mehmetfurkandogan/Microprocessor-Controlled-Prosthetic-Knee/Controller GUI/c-leg.png

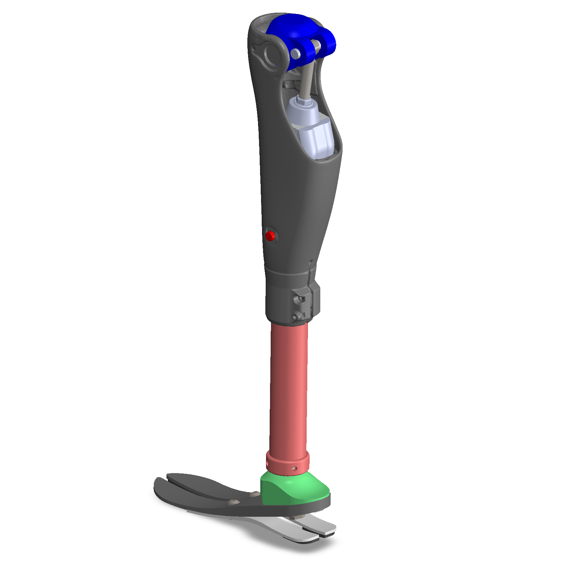
Controller GUI/c-leg.png
