mehmetfurkandogan/Microprocessor-Controlled-Prosthetic-Knee/Simulink_Simulation/C-Leg STEP/Valf/assembly_v2.SLDASM

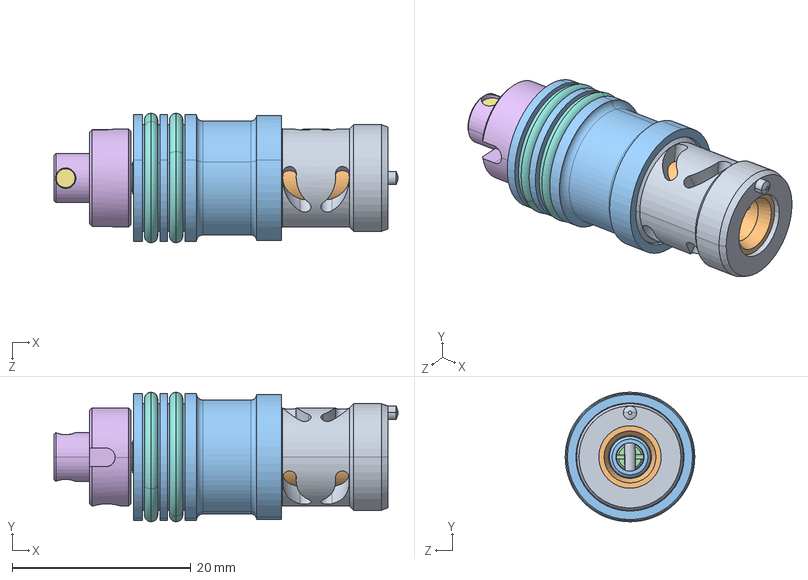
[picture p3: CAD file, 2023-01-23]
Simulink_Simulation/C-Leg STEP/Valf/assembly_v2.SLDASM
38.5 x 14.5 x 14.5 mm
Part9_by_can.step
ic_parca_step.step
Part3_step.step
motor_shaft_step.step
buyuk_pul_step.step
Part4_step.step
Part2_step.step
jonta_step.step
pim_step.step
Part6_step.step
Part7_step.step
kucuk_pul_step.step
Part10_step.step
Part11_step.step
mıknatıs_step.step
o_ring_step.step x 2
