mehmetfurkandogan/Microprocessor-Controlled-Prosthetic-Knee/Simulink_Simulation/karbon ayak/karbon ayak step/assembly step.STEP

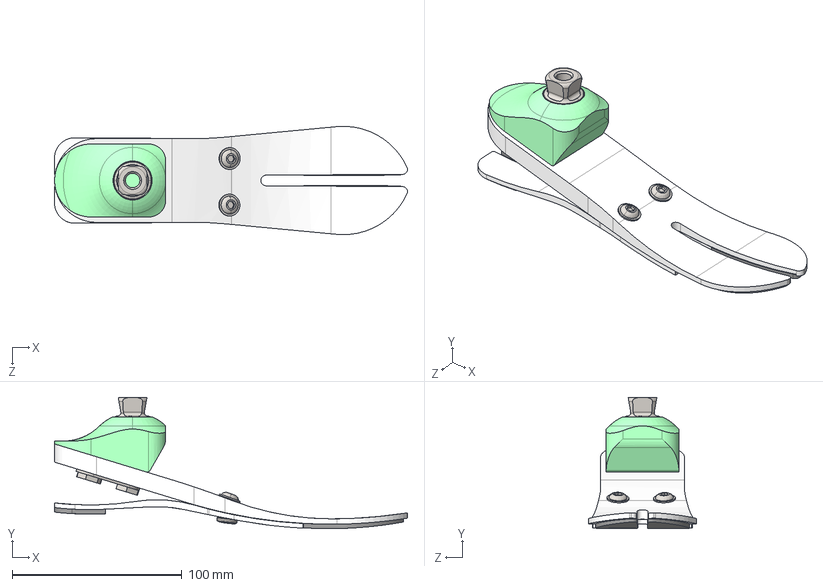
[picture p4: CAD file, 2023-01-23]
Simulink_Simulation/karbon ayak/karbon ayak step/assembly step.STEP
208.0 x 77.5 x 63.8 mm
TI.2K.PT10
DT.2P. KTB2
DT.2P.KTBN
YH.PU.K207
TI.VI.A816 x 2
HP.VI.I612_K6SF1006012_BUFAB x 2
TI.K2.0004
KA.KL.027U
KA.KL.027A
TI.K7.0003 x 2
TI.VI.A820
