mehmetfurkandogan/Microprocessor-Controlled-Prosthetic-Knee/Simulink_Simulation/C-Leg STEP/Valf/montaj_ic_aksam_v3.SLDASM

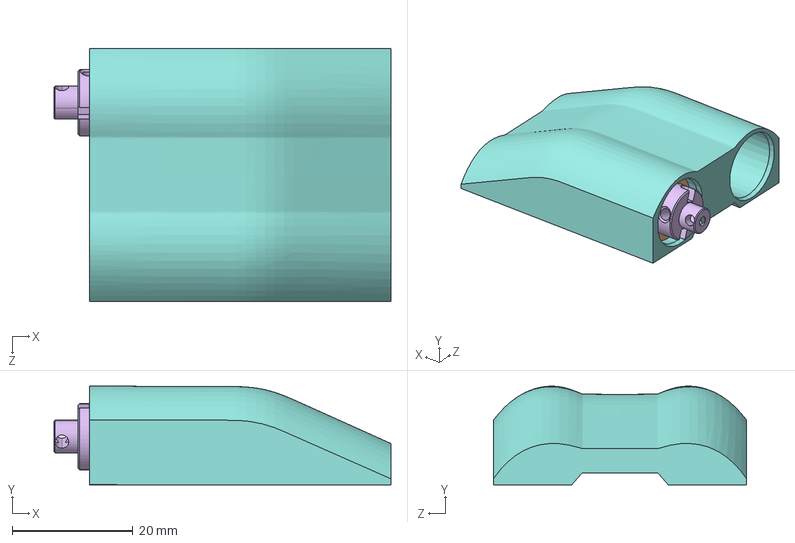
[picture p6: CAD file, 2023-01-23]
Simulink_Simulation/C-Leg STEP/Valf/montaj_ic_aksam_v3.SLDASM
55.9 x 16.4 x 42.0 mm
Part9_by_can.step
motor_shaft_step.step
buyuk_pul_step.step
Part3_step.step
pim_step.step
ic_parca_step.step
Part4_step.step
Part6_step.step
Part7_step.step
Part2_step.step
jonta_step.step
kucuk_pul_step.step
Part11_step.step
o_ring_step x 2
