mehmetfurkandogan/Microprocessor-Controlled-Prosthetic-Knee/Simulink_Simulation/C-Leg STEP/Valf/Assem1.SLDASM

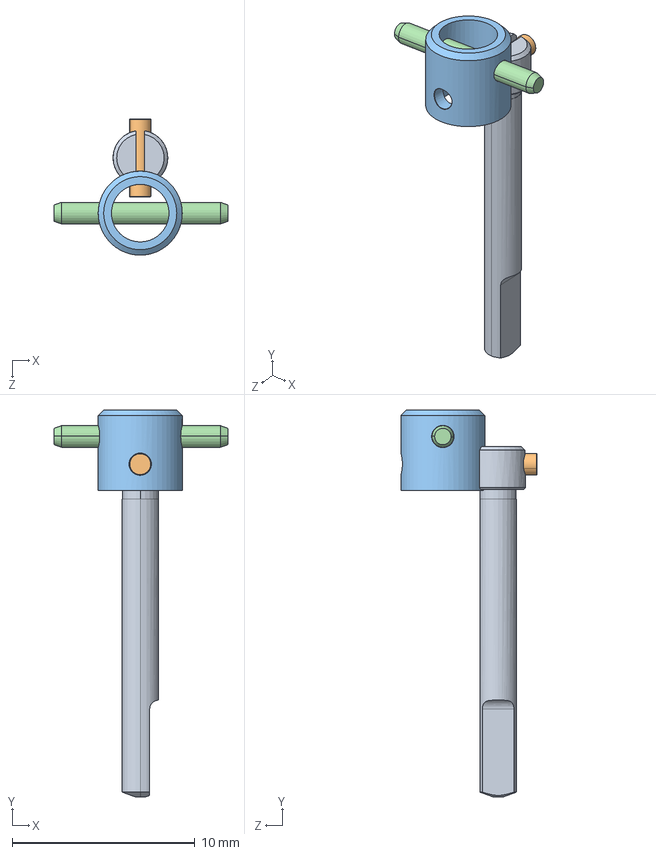
[picture p7: CAD file, 2023-01-23]
Simulink_Simulation/C-Leg STEP/Valf/Assem1.SLDASM
9.50 x 21.2 x 7.46 mm
motor_shaft_step.step
Part5_step.step
Part3_step.step
pim_step.step
