mehmetfurkandogan/Microprocessor-Controlled-Prosthetic-Knee/Simulink_Simulation/C-Leg STEP/Valf/montaj.SLDASM

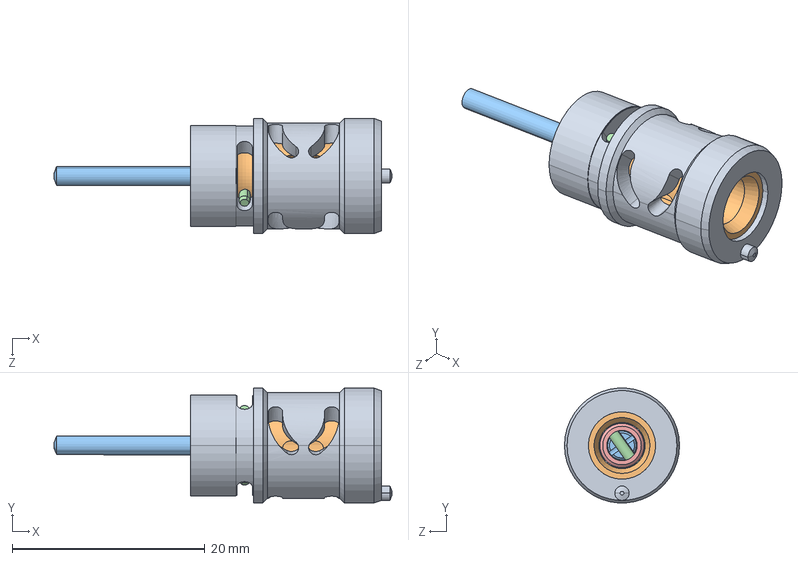
[picture p8: CAD file, 2023-01-23]
Simulink_Simulation/C-Leg STEP/Valf/montaj.SLDASM
35.1 x 11.9 x 11.9 mm
dis_parca_step.step
ic_parca_step.step
motor_shaft_step.step
pim_step.step
Part3_step.step
buyuk_pul_step.step
