mehmetfurkandogan/Microprocessor-Controlled-Prosthetic-Knee/Simulink_Simulation/C-Leg STEP/Valf/montaj_ic_aksam.SLDASM

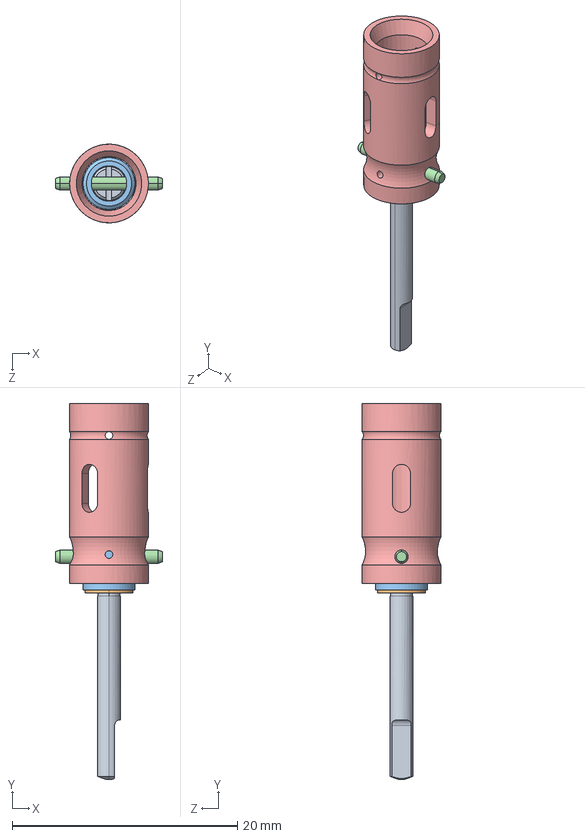
[picture p9: CAD file, 2023-01-23]
Simulink_Simulation/C-Leg STEP/Valf/montaj_ic_aksam.SLDASM
9.50 x 33.4 x 6.99 mm
motor_shaft_step.step
buyuk_pul_step.step
Part3_step.step
pim_step.step
ic_parca_step.step
