mehmetfurkandogan/Microprocessor-Controlled-Prosthetic-Knee/Simulink_Simulation/C-Leg STEP/Parçalar/valf_govdesi_v2.STEP

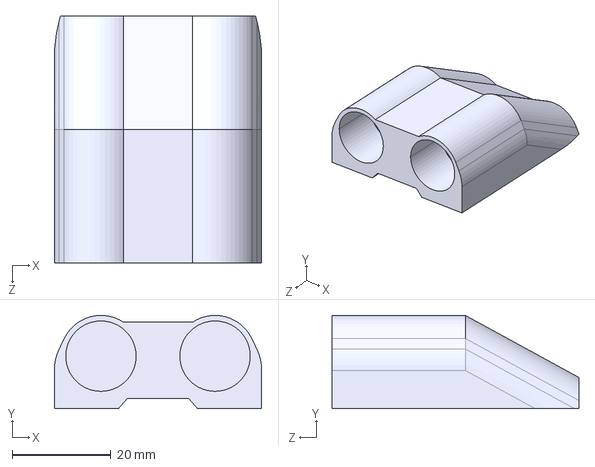
[picture p10: CAD file, 2023-01-23]
Simulink_Simulation/C-Leg STEP/Parçalar/valf_govdesi_v2.STEP
42.0 x 18.9 x 50.0 mm
