mehmetfurkandogan/Microprocessor-Controlled-Prosthetic-Knee/Simulink_Simulation/C-Leg STEP/Valf/kucuk_pul_step.STEP

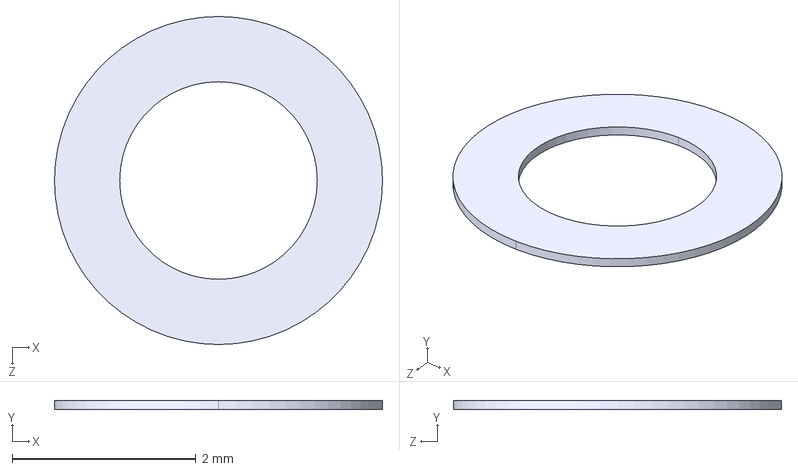
[picture p11: CAD file, 2023-01-23]
Simulink_Simulation/C-Leg STEP/Valf/kucuk_pul_step.STEP
3.57 x 0.1 x 3.57 mm
