mehmetfurkandogan/Microprocessor-Controlled-Prosthetic-Knee/Simulink_Simulation/karbon ayak/karbon ayak step/DT.2P.KTBN.STEP

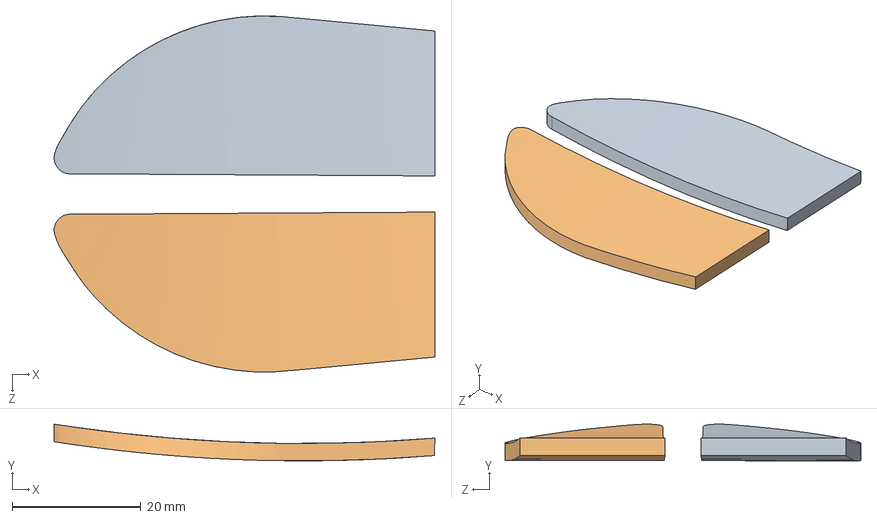
[picture p12: CAD file, 2023-01-23]
Simulink_Simulation/karbon ayak/karbon ayak step/DT.2P.KTBN.STEP
59.1 x 5.71 x 55.2 mm
