mehmetfurkandogan/Microprocessor-Controlled-Prosthetic-Knee/Simulink_Simulation/simulink/boru.STEP

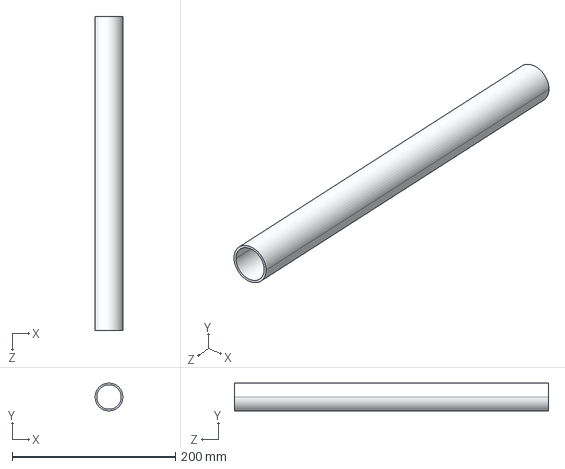
[picture p14: CAD file, 2023-01-23]
Simulink_Simulation/simulink/boru.STEP
34.0 x 34.0 x 385.0 mm
