mehmetfurkandogan/Microprocessor-Controlled-Prosthetic-Knee/Simulink_Simulation/C-Leg STEP/Parçalar/Cool-Step Govde_v2.step.SLDPRT

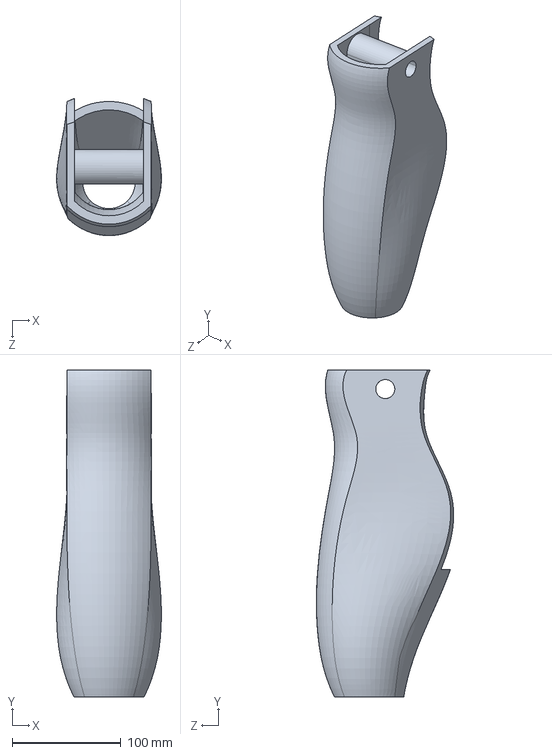
[picture p15: CAD file, 2023-01-23]
Simulink_Simulation/C-Leg STEP/Parçalar/Cool-Step Govde_v2.step.SLDPRT
96.1 x 300.0 x 126.0 mm
