mehmetfurkandogan/Microprocessor-Controlled-Prosthetic-Knee/Simulink_Simulation/C-Leg STEP/Valf/o_ring_step.STEP

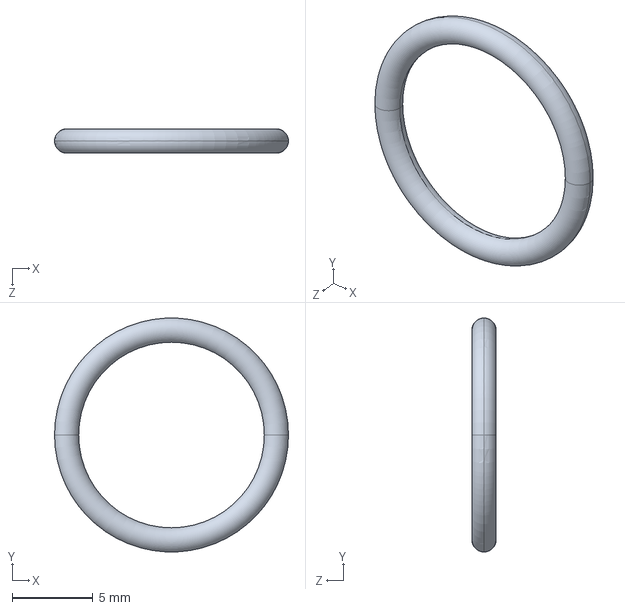
[picture p16: CAD file, 2023-01-23]
Simulink_Simulation/C-Leg STEP/Valf/o_ring_step.STEP
14.5 x 14.5 x 1.50 mm
