mehmetfurkandogan/Microprocessor-Controlled-Prosthetic-Knee/Simulink_Simulation/diz.STEP

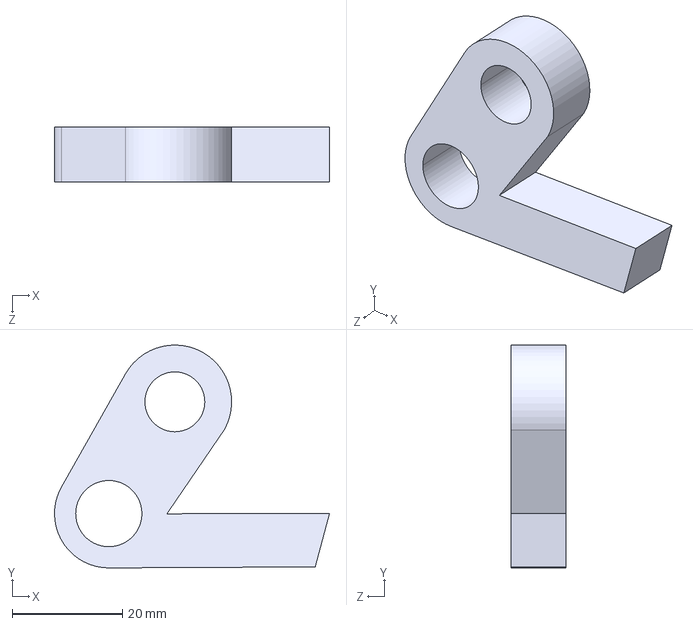
[picture p17: CAD file, 2023-01-23]
Simulink_Simulation/diz.STEP
49.8 x 40.4 x 10.0 mm
