mehmetfurkandogan/Microprocessor-Controlled-Prosthetic-Knee/Simulink_Simulation/karbon ayak/HP.VI.I612.SLDPRT

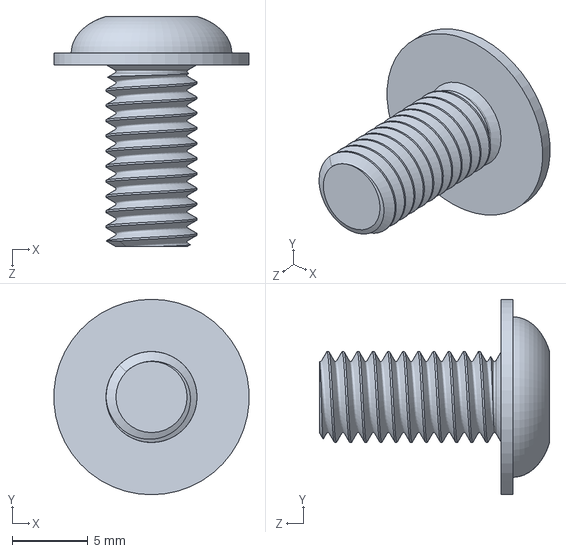
[picture p18: CAD file, 2023-01-23]
Simulink_Simulation/karbon ayak/HP.VI.I612.SLDPRT
12.9 x 12.9 x 15.2 mm
