mehmetfurkandogan/Microprocessor-Controlled-Prosthetic-Knee/Simulink_Simulation/karbon ayak/karbon ayak step/KA.KL.027U.STEP

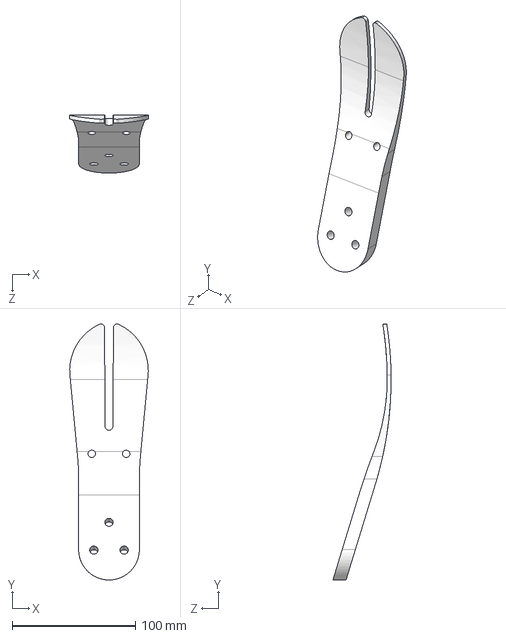
[picture p19: CAD file, 2023-01-23]
Simulink_Simulation/karbon ayak/karbon ayak step/KA.KL.027U.STEP
63.8 x 208.0 x 47.3 mm
