mehmetfurkandogan/Microprocessor-Controlled-Prosthetic-Knee/Simulink_Simulation/simulink/01-ADAPTÖR.STEP

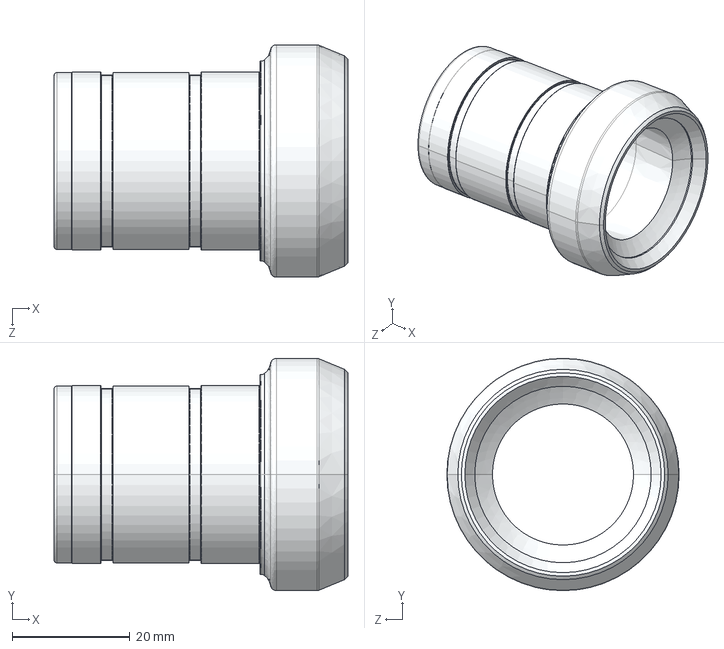
[picture p20: CAD file, 2023-01-23]
Simulink_Simulation/simulink/01-ADAPTÖR.STEP
50.0 x 39.5 x 39.5 mm
