mehmetfurkandogan/Microprocessor-Controlled-Prosthetic-Knee/Simulink_Simulation/C-Leg STEP/Parçalar/diz.STEP

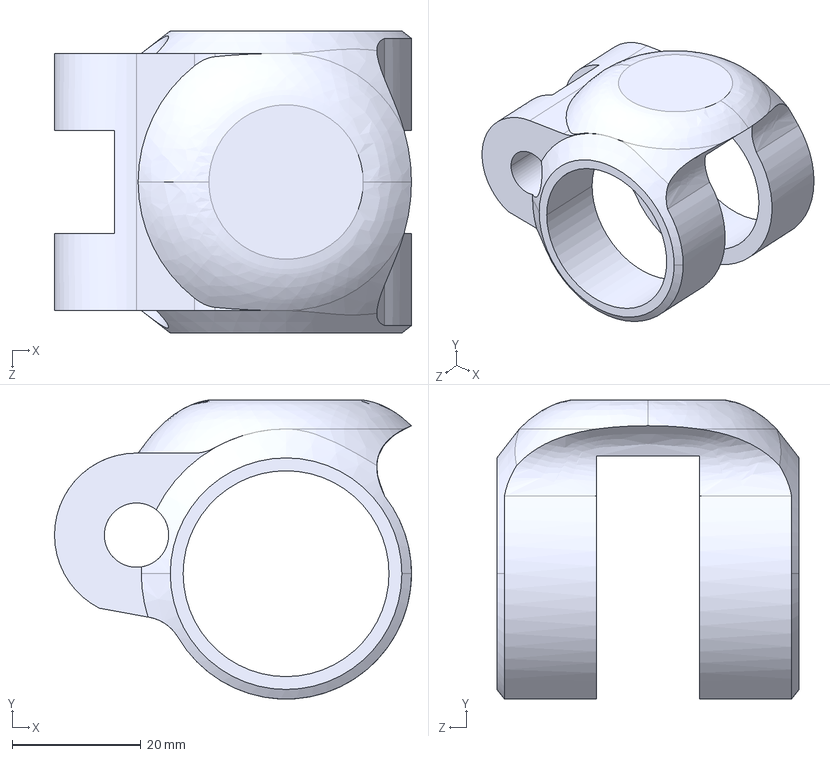
[picture p21: CAD file, 2023-01-23]
Simulink_Simulation/C-Leg STEP/Parçalar/diz.STEP
55.5 x 46.5 x 47.0 mm
