mehmetfurkandogan/Microprocessor-Controlled-Prosthetic-Knee/Simulink_Simulation/karbon ayak/karbon ayak step/KA.KL.027A.STEP

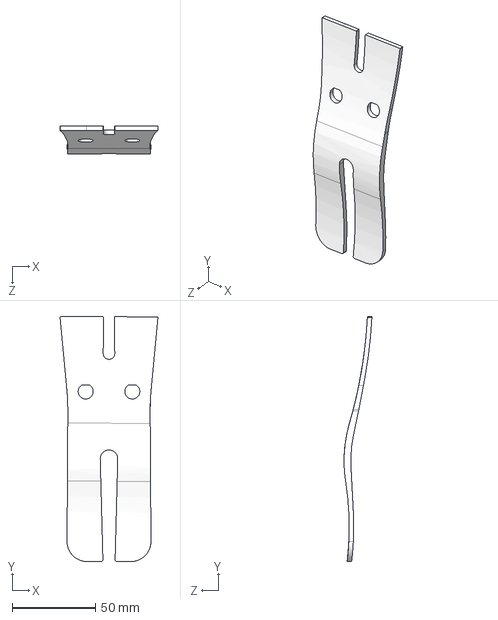
[picture p22: CAD file, 2023-01-23]
Simulink_Simulation/karbon ayak/karbon ayak step/KA.KL.027A.STEP
58.7 x 147.0 x 16.7 mm
