mehmetfurkandogan/Microprocessor-Controlled-Prosthetic-Knee/Simulink_Simulation/simulink/strain_gage_parcasi_kare.STEP

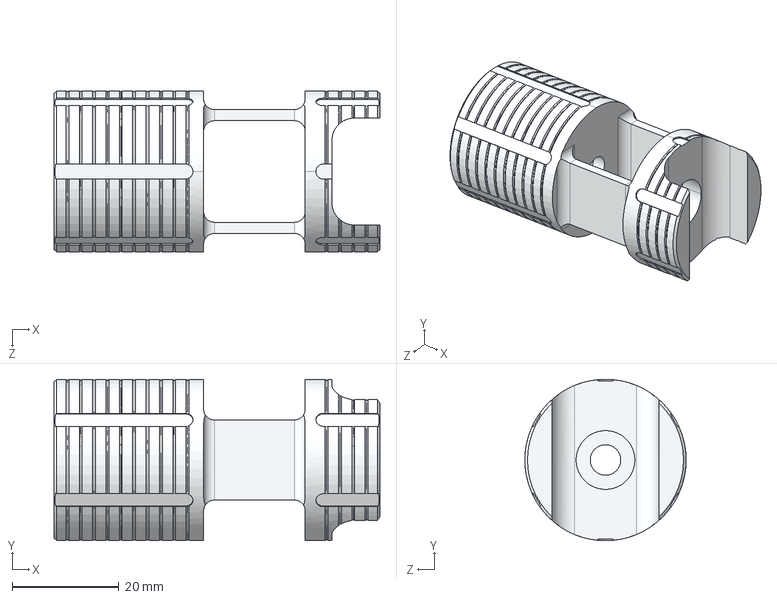
[picture p23: CAD file, 2023-01-23]
Simulink_Simulation/simulink/strain_gage_parcasi_kare.STEP
61.0 x 30.2 x 30.2 mm
