mehmetfurkandogan/Microprocessor-Controlled-Prosthetic-Knee/Simulink_Simulation/C-Leg STEP/Parçalar/hidrolikSilindir.STEP

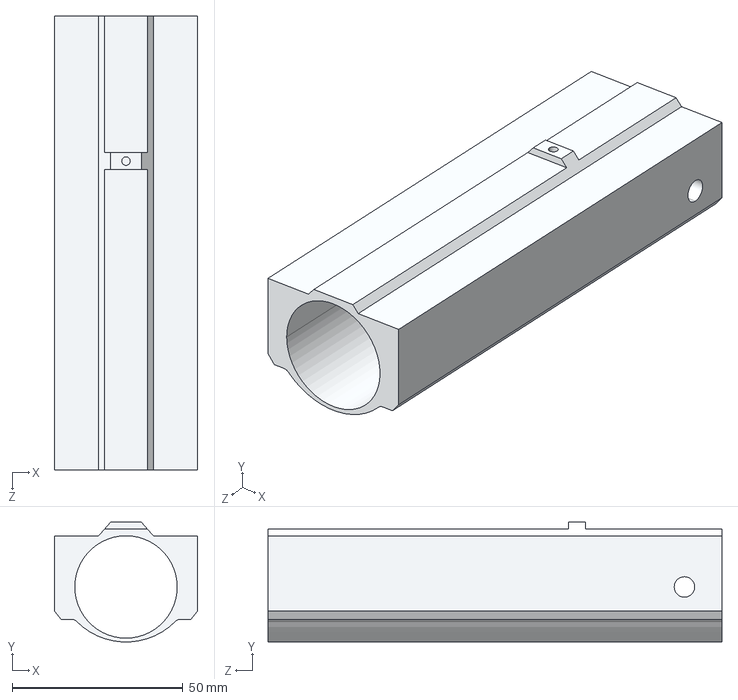
[picture p24: CAD file, 2023-01-23]
Simulink_Simulation/C-Leg STEP/Parçalar/hidrolikSilindir.STEP
42.0 x 35.1 x 133.0 mm
