mehmetfurkandogan/Microprocessor-Controlled-Prosthetic-Knee/Simulink_Simulation/C-Leg STEP/Valf/Part9_by_can.STEP

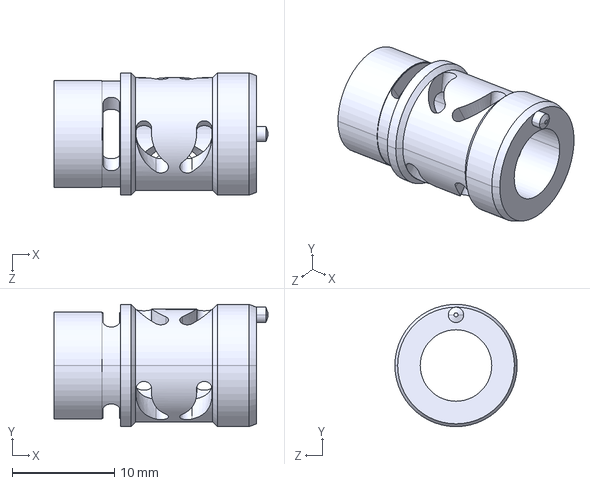
[picture p25: CAD file, 2023-01-23]
Simulink_Simulation/C-Leg STEP/Valf/Part9_by_can.STEP
20.9 x 12.0 x 12.0 mm
