mehmetfurkandogan/Microprocessor-Controlled-Prosthetic-Knee/Simulink_Simulation/simulink/boru_v2SLDPRT.SLDPRT

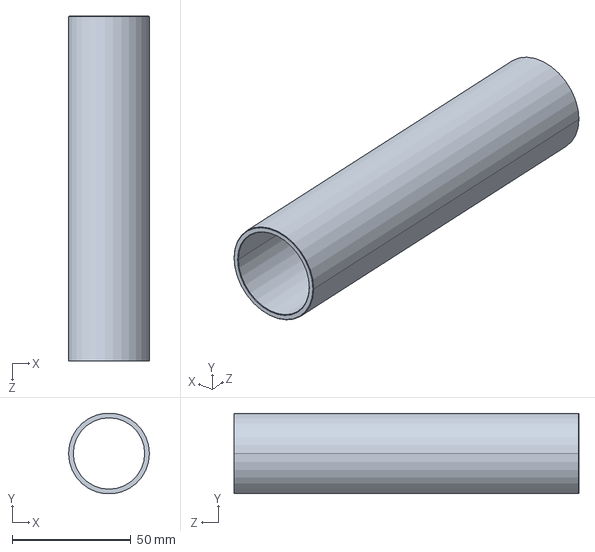
[picture p26: CAD file, 2023-01-23]
Simulink_Simulation/simulink/boru_v2SLDPRT.SLDPRT
34.0 x 33.8 x 145.0 mm
