mehmetfurkandogan/Microprocessor-Controlled-Prosthetic-Knee/Simulink_Simulation/C-Leg STEP/Parçalar/valf_govdesi_v3.SLDPRT

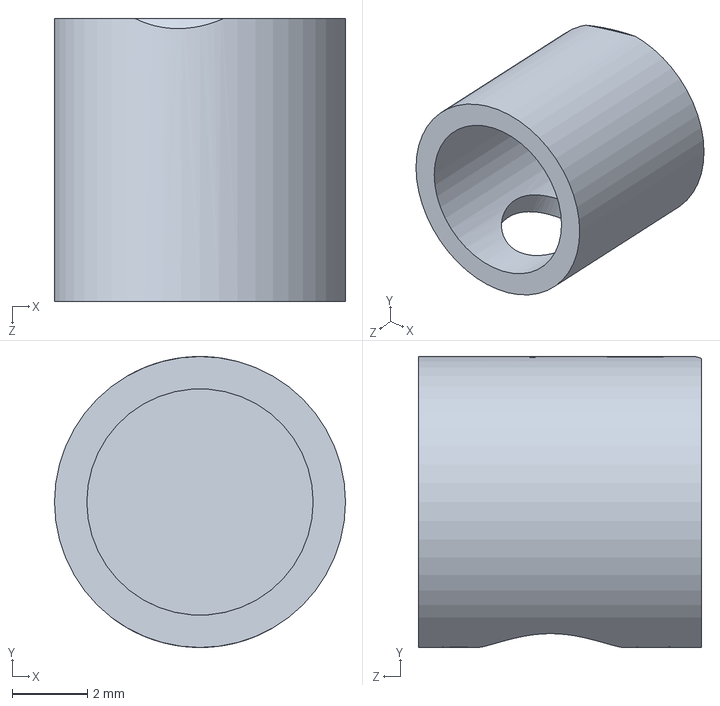
[picture p27: CAD file, 2023-01-23]
Simulink_Simulation/C-Leg STEP/Parçalar/valf_govdesi_v3.SLDPRT
7.72 x 7.72 x 7.50 mm
