mehmetfurkandogan/Microprocessor-Controlled-Prosthetic-Knee/Simulink_Simulation/C-Leg STEP/Valf/Part4_step.STEP

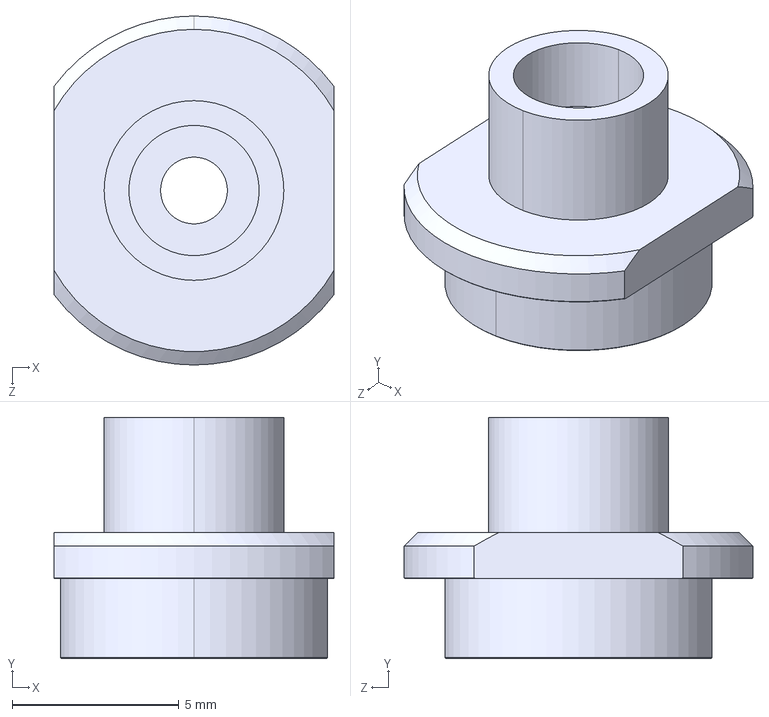
[picture p28: CAD file, 2023-01-23]
Simulink_Simulation/C-Leg STEP/Valf/Part4_step.STEP
8.38 x 7.22 x 10.5 mm
