mehmetfurkandogan/Microprocessor-Controlled-Prosthetic-Knee/Simulink_Simulation/karbon ayak/YH.PU.K207.SLDPRT

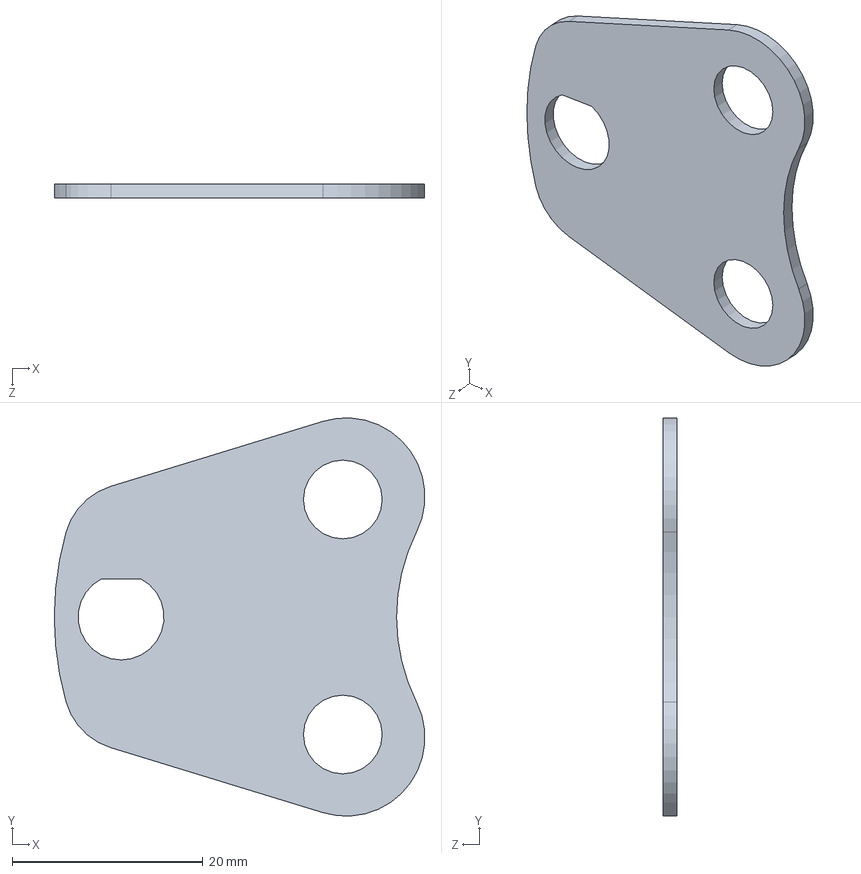
[picture p29: CAD file, 2023-01-23]
Simulink_Simulation/karbon ayak/YH.PU.K207.SLDPRT
38.8 x 41.7 x 1.50 mm
