mehmetfurkandogan/Microprocessor-Controlled-Prosthetic-Knee/Simulink_Simulation/karbon ayak/karbon ayak step/TI.K2.0004.STEP

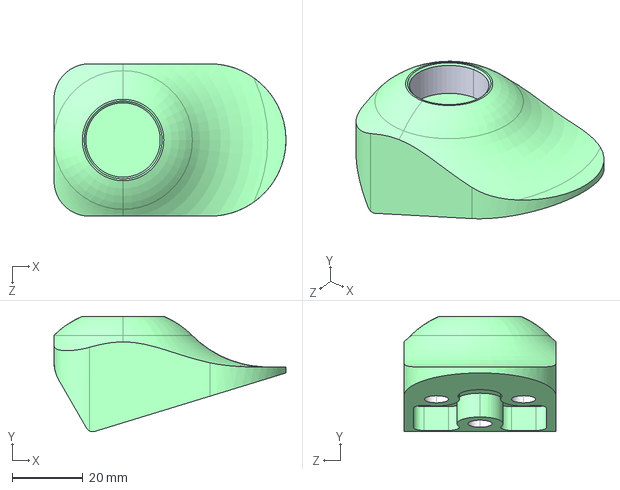
[picture p30: CAD file, 2023-01-23]
Simulink_Simulation/karbon ayak/karbon ayak step/TI.K2.0004.STEP
65.5 x 32.6 x 43.0 mm
