mehmetfurkandogan/Microprocessor-Controlled-Prosthetic-Knee/Simulink_Simulation/karbon ayak/TI.VI.A816.SLDPRT

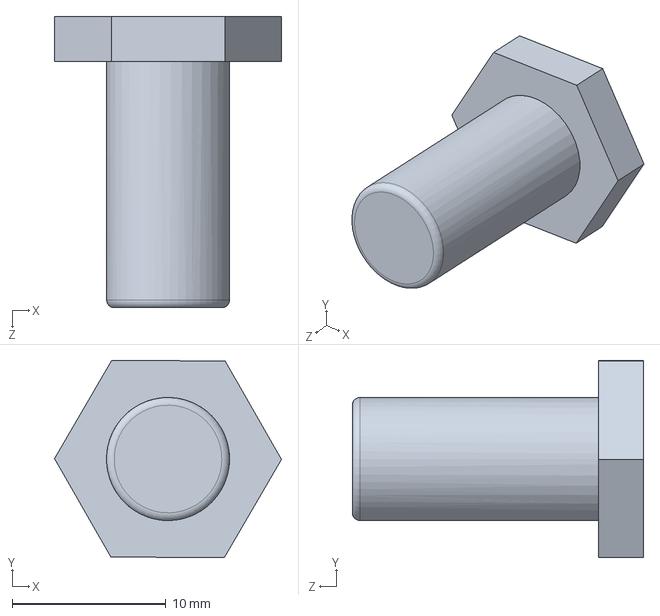
[picture p31: CAD file, 2023-01-23]
Simulink_Simulation/karbon ayak/TI.VI.A816.SLDPRT
14.8 x 12.8 x 19.0 mm
