mehmetfurkandogan/Microprocessor-Controlled-Prosthetic-Knee/Simulink_Simulation/C-Leg STEP/Valf/pim_step.STEP

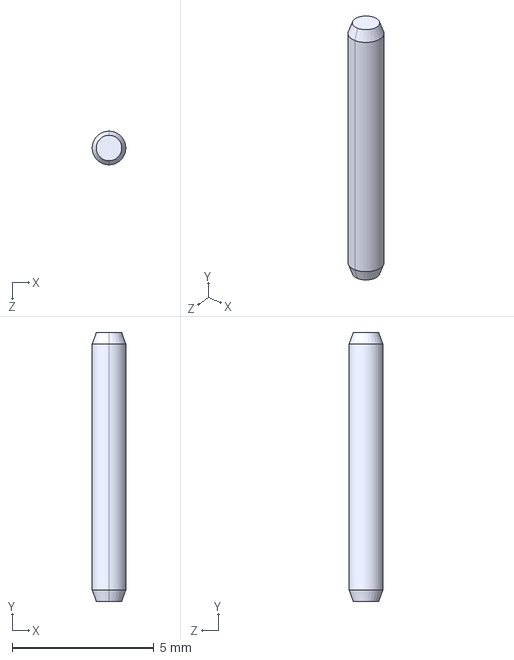
[picture p32: CAD file, 2023-01-23]
Simulink_Simulation/C-Leg STEP/Valf/pim_step.STEP
1.19 x 9.50 x 1.19 mm
