mehmetfurkandogan/Microprocessor-Controlled-Prosthetic-Knee/Simulink_Simulation/karbon ayak/karbon ayak step/DT.2P. KTB2.STEP

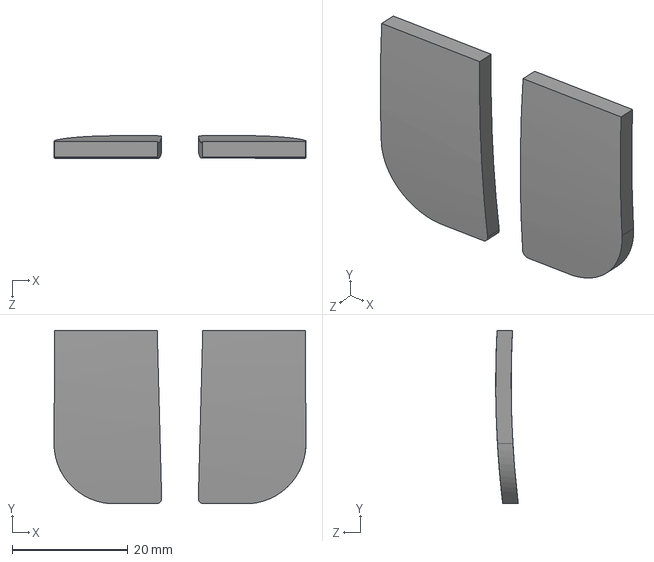
[picture p33: CAD file, 2023-01-23]
Simulink_Simulation/karbon ayak/karbon ayak step/DT.2P. KTB2.STEP
43.6 x 30.0 x 3.92 mm
