mehmetfurkandogan/Microprocessor-Controlled-Prosthetic-Knee/Simulink_Simulation/karbon ayak/TI.K2.0004.SLDPRT

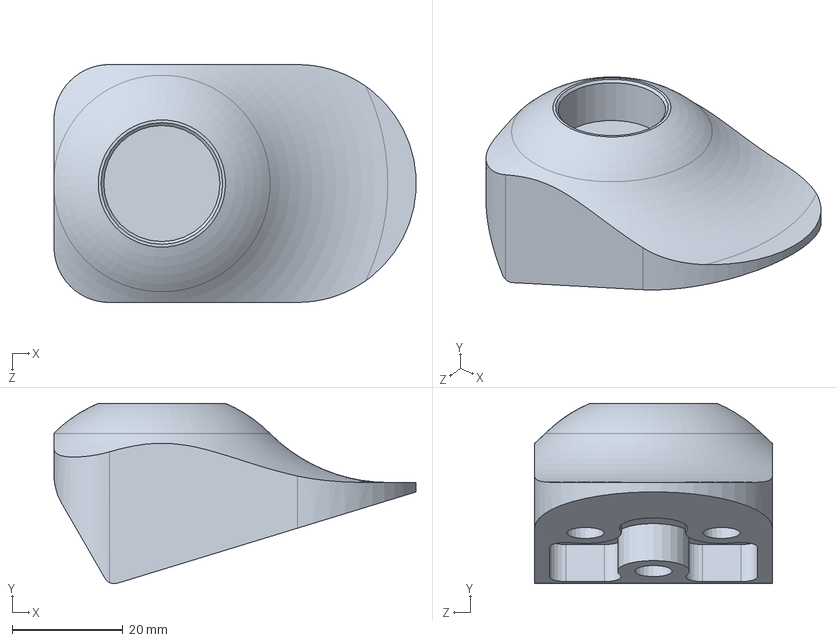
[picture p34: CAD file, 2023-01-23]
Simulink_Simulation/karbon ayak/TI.K2.0004.SLDPRT
65.4 x 32.6 x 43.0 mm
