mehmetfurkandogan/Microprocessor-Controlled-Prosthetic-Knee/Simulink_Simulation/karbon ayak/DT.2P.KTBN.SLDPRT

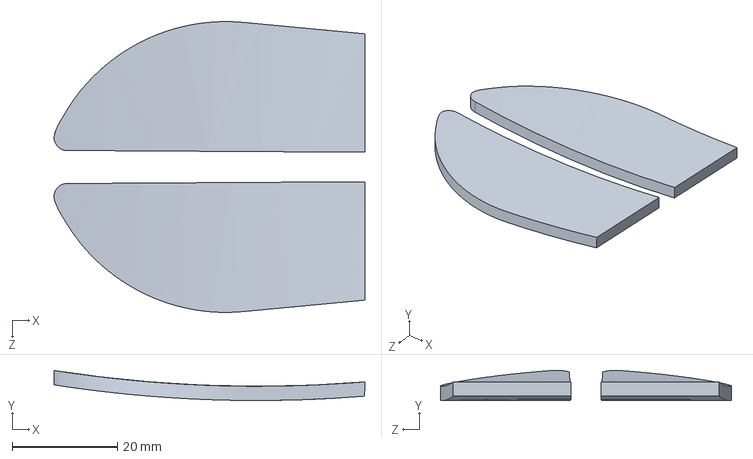
[picture p35: CAD file, 2023-01-23]
Simulink_Simulation/karbon ayak/DT.2P.KTBN.SLDPRT
59.1 x 5.71 x 55.3 mm
