mehmetfurkandogan/Microprocessor-Controlled-Prosthetic-Knee/Simulink_Simulation/C-Leg STEP/Valf/Part10_step.STEP

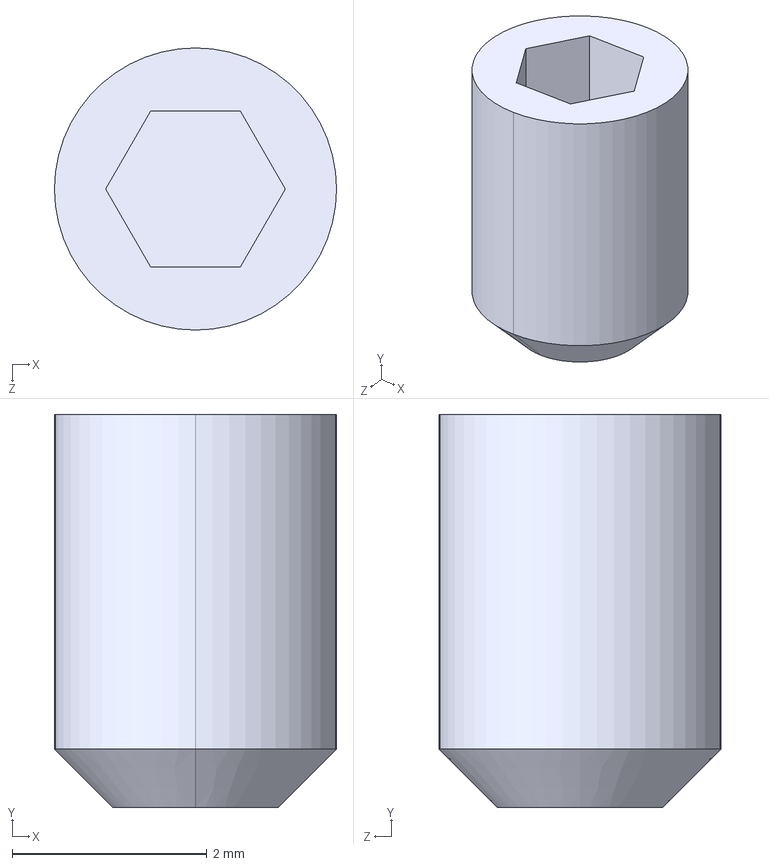
[picture p36: CAD file, 2023-01-23]
Simulink_Simulation/C-Leg STEP/Valf/Part10_step.STEP
2.90 x 4.04 x 2.90 mm
