mehmetfurkandogan/Microprocessor-Controlled-Prosthetic-Knee/Simulink_Simulation/karbon ayak/TI.VI.A820.SLDPRT

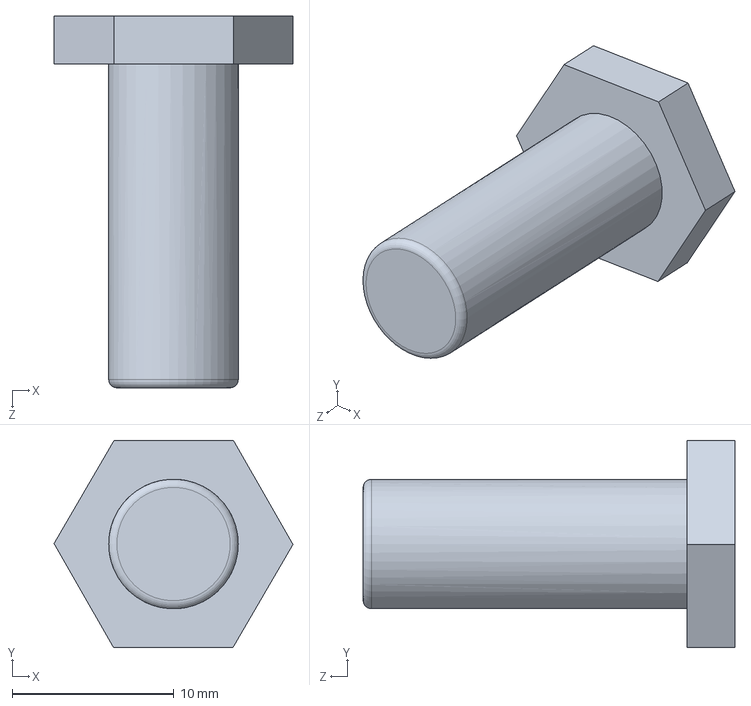
[picture p37: CAD file, 2023-01-23]
Simulink_Simulation/karbon ayak/TI.VI.A820.SLDPRT
14.8 x 12.8 x 22.9 mm
