mehmetfurkandogan/Microprocessor-Controlled-Prosthetic-Knee/Simulink_Simulation/karbon ayak/karbon ayak step/TI.2K.PT10.STEP

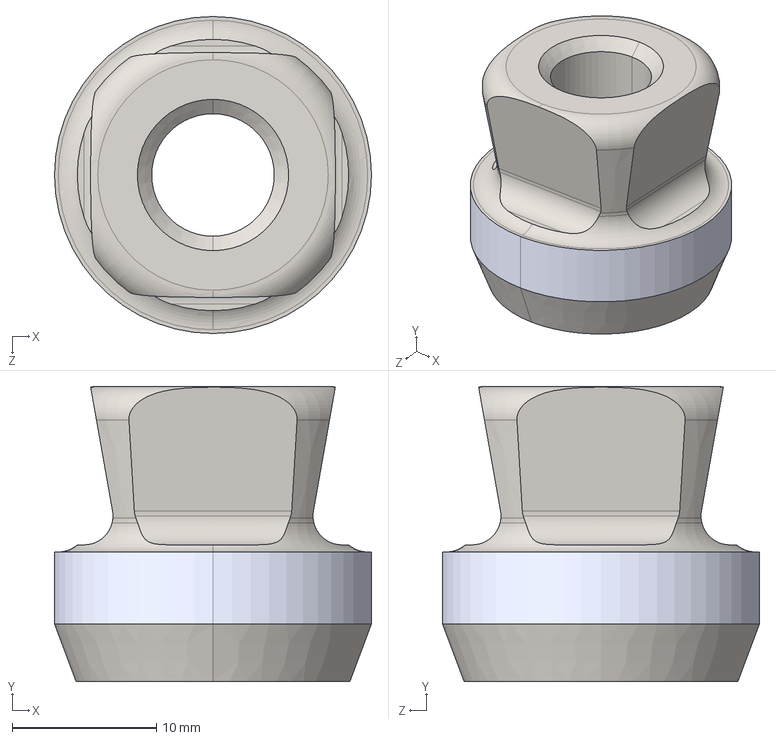
[picture p38: CAD file, 2023-01-23]
Simulink_Simulation/karbon ayak/karbon ayak step/TI.2K.PT10.STEP
22.0 x 20.5 x 22.0 mm
