mehmetfurkandogan/Microprocessor-Controlled-Prosthetic-Knee/Simulink_Simulation/karbon ayak/TI.2K.PT10.SLDPRT

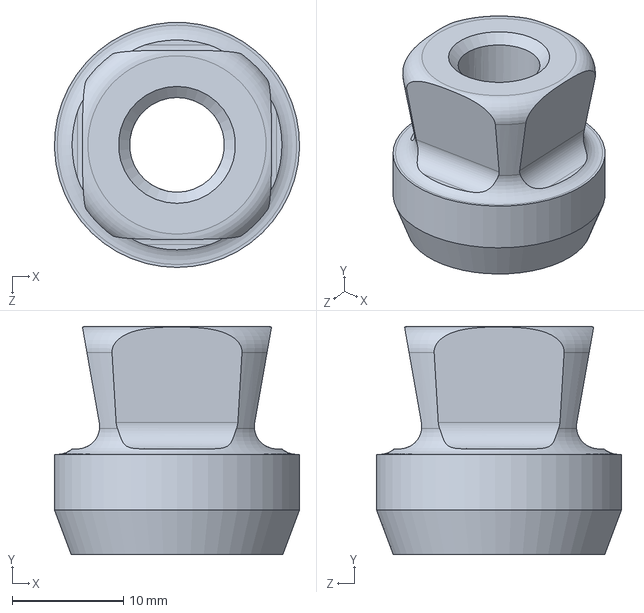
[picture p39: CAD file, 2023-01-23]
Simulink_Simulation/karbon ayak/TI.2K.PT10.SLDPRT
22.0 x 20.5 x 22.0 mm
