mehmetfurkandogan/Microprocessor-Controlled-Prosthetic-Knee/Simulink_Simulation/C-Leg STEP/Valf/motor_shaft_step.STEP

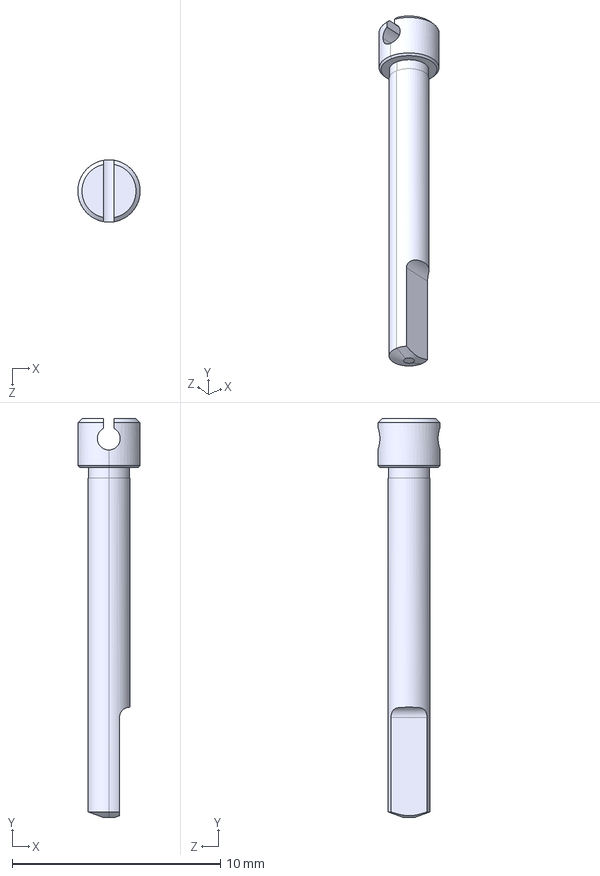
[picture p40: CAD file, 2023-01-23]
Simulink_Simulation/C-Leg STEP/Valf/motor_shaft_step.STEP
3.00 x 19.2 x 3.00 mm
