mehmetfurkandogan/Microprocessor-Controlled-Prosthetic-Knee/Simulink_Simulation/C-Leg STEP/Valf/mıknatıs_step.STEP

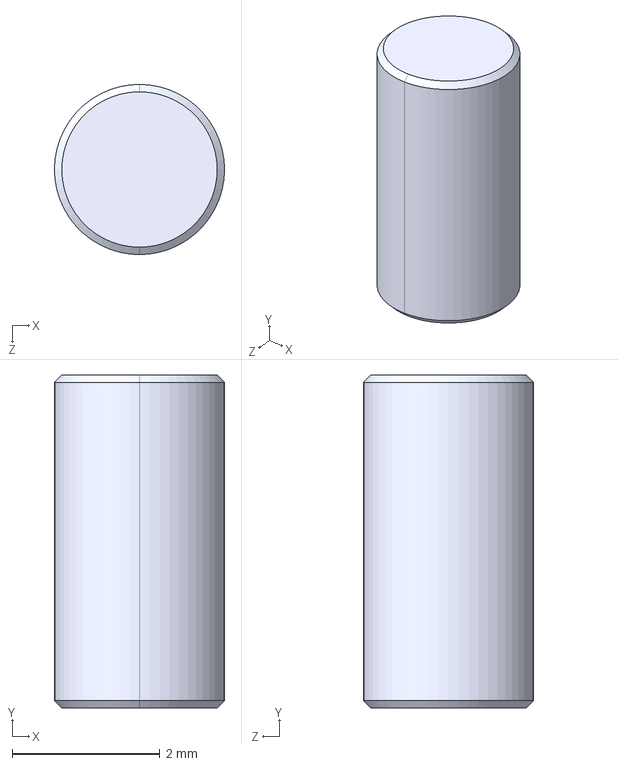
[picture p41: CAD file, 2023-01-23]
Simulink_Simulation/C-Leg STEP/Valf/mıknatıs_step.STEP
2.30 x 4.50 x 2.30 mm
