mehmetfurkandogan/Microprocessor-Controlled-Prosthetic-Knee/Simulink_Simulation/C-Leg STEP/Valf/ic_parca_step.STEP

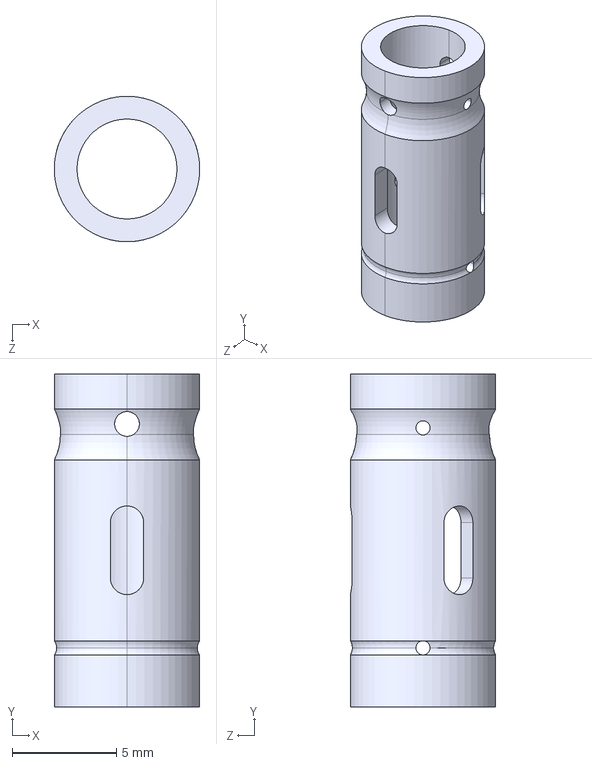
[picture p42: CAD file, 2023-01-23]
Simulink_Simulation/C-Leg STEP/Valf/ic_parca_step.STEP
6.99 x 16.0 x 6.99 mm
