mehmetfurkandogan/Microprocessor-Controlled-Prosthetic-Knee/Simulink_Simulation/karbon ayak/karbon ayak step/TI.K2.0014.STEP

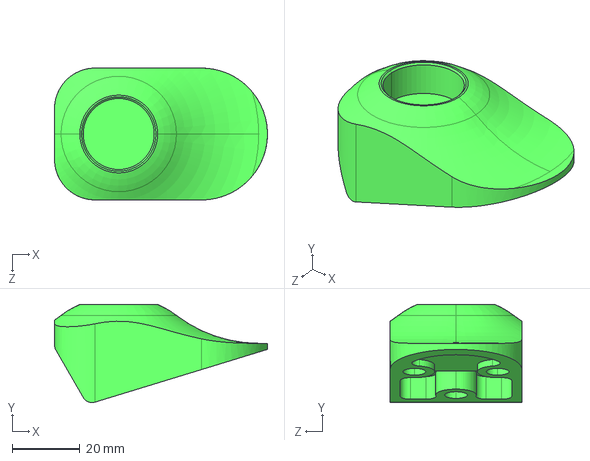
[picture p43: CAD file, 2023-01-23]
Simulink_Simulation/karbon ayak/karbon ayak step/TI.K2.0014.STEP
63.0 x 29.0 x 39.0 mm
