mehmetfurkandogan/Microprocessor-Controlled-Prosthetic-Knee/Simulink_Simulation/C-Leg STEP/Valf/Part11_step.STEP

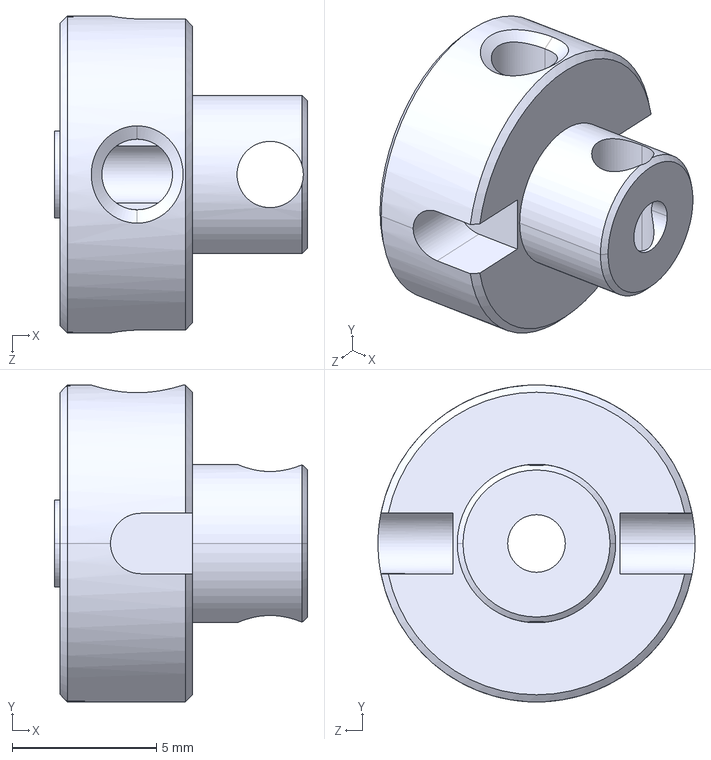
[picture p44: CAD file, 2023-01-23]
Simulink_Simulation/C-Leg STEP/Valf/Part11_step.STEP
8.79 x 11.0 x 11.0 mm
