mehmetfurkandogan/Microprocessor-Controlled-Prosthetic-Knee/Simulink_Simulation/C-Leg STEP/Valf/Part2_step.STEP

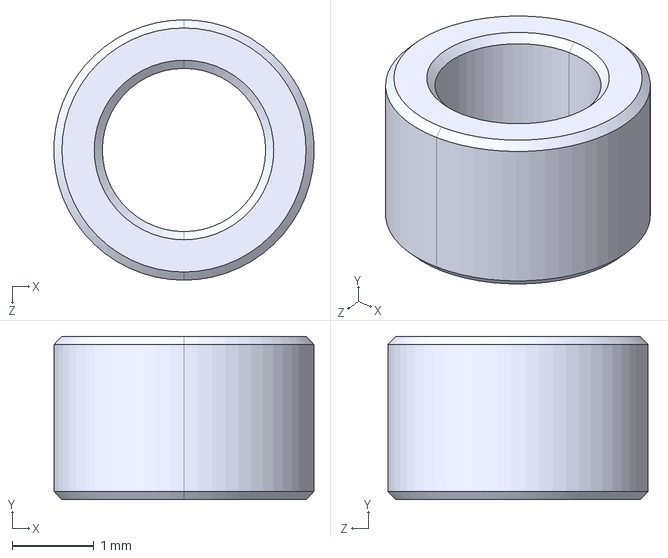
[picture p45: CAD file, 2023-01-23]
Simulink_Simulation/C-Leg STEP/Valf/Part2_step.STEP
3.19 x 2.00 x 3.19 mm
