mehmetfurkandogan/Microprocessor-Controlled-Prosthetic-Knee/Simulink_Simulation/C-Leg STEP/Valf/Part6_step.STEP

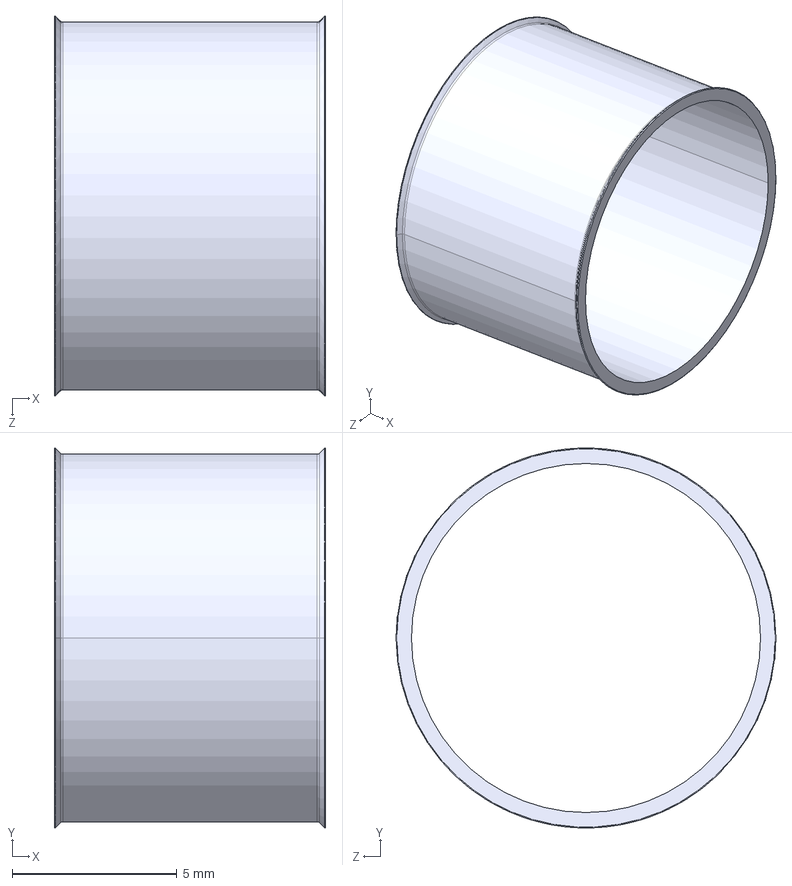
[picture p46: CAD file, 2023-01-23]
Simulink_Simulation/C-Leg STEP/Valf/Part6_step.STEP
8.24 x 11.5 x 11.5 mm
