mehmetfurkandogan/Microprocessor-Controlled-Prosthetic-Knee/Simulink_Simulation/C-Leg STEP/Valf/Part3_step.STEP

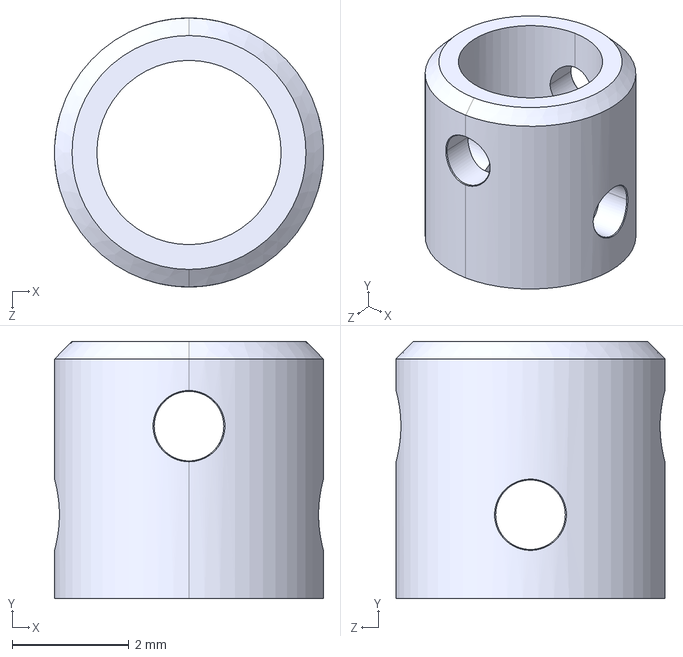
[picture p47: CAD file, 2023-01-23]
Simulink_Simulation/C-Leg STEP/Valf/Part3_step.STEP
4.60 x 4.40 x 4.60 mm
