mehmetfurkandogan/Microprocessor-Controlled-Prosthetic-Knee/Simulink_Simulation/C-Leg STEP/Valf/Part5_step.STEP

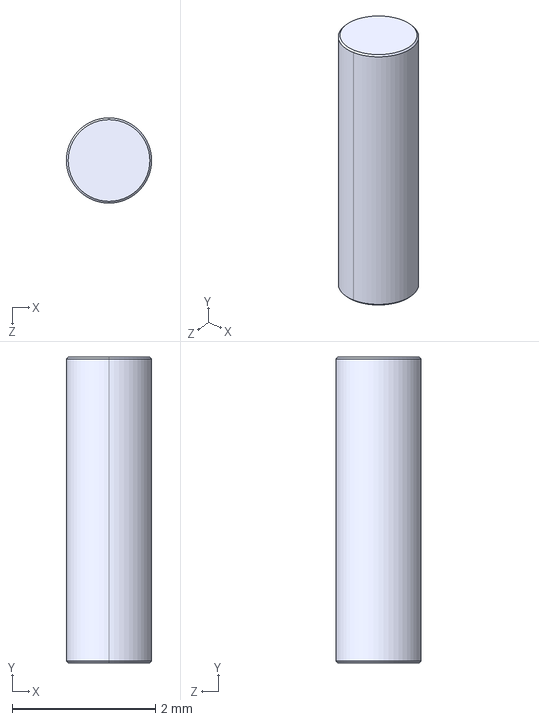
[picture p48: CAD file, 2023-01-23]
Simulink_Simulation/C-Leg STEP/Valf/Part5_step.STEP
1.19 x 4.27 x 1.19 mm
