mehmetfurkandogan/Microprocessor-Controlled-Prosthetic-Knee/Simulink_Simulation/C-Leg STEP/Valf/Part7_step.STEP

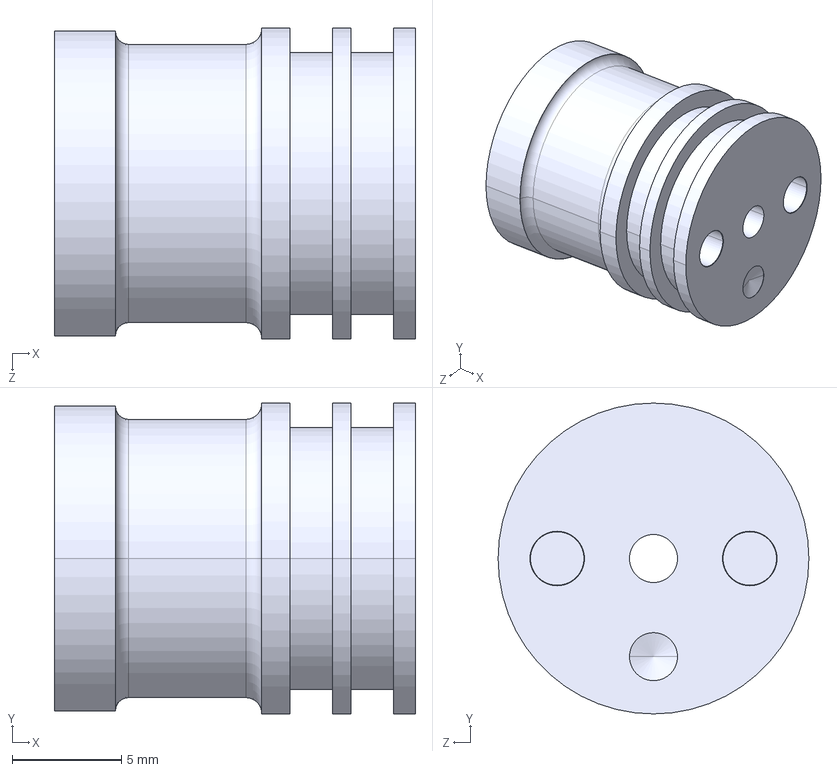
[picture p49: CAD file, 2023-01-23]
Simulink_Simulation/C-Leg STEP/Valf/Part7_step.STEP
16.5 x 14.2 x 14.2 mm
