mehmetfurkandogan/Microprocessor-Controlled-Prosthetic-Knee/Simulink_Simulation/C-Leg STEP/Valf/buyuk_pul_step.STEP

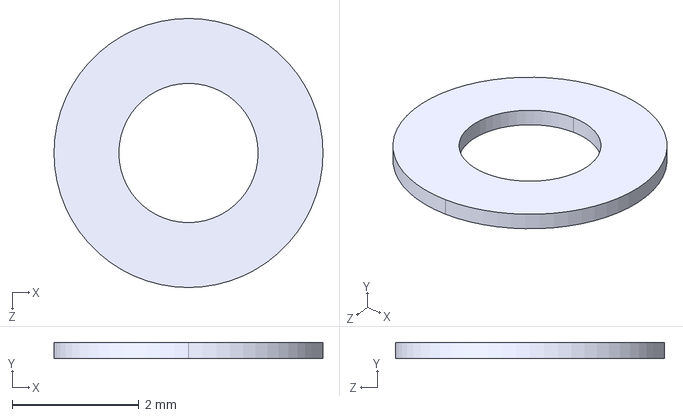
[picture p50: CAD file, 2023-01-23]
Simulink_Simulation/C-Leg STEP/Valf/buyuk_pul_step.STEP
4.25 x 0.26 x 4.25 mm
