mehmetfurkandogan/Microprocessor-Controlled-Prosthetic-Knee/Simulink_Simulation/C-Leg STEP/Valf/jonta_step.STEP

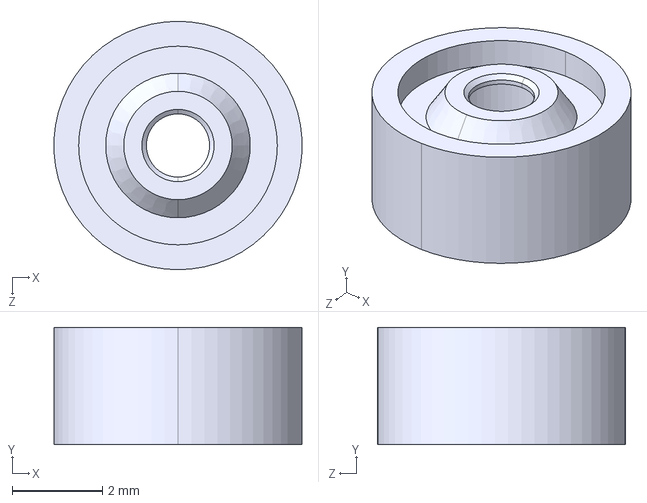
[picture p51: CAD file, 2023-01-23]
Simulink_Simulation/C-Leg STEP/Valf/jonta_step.STEP
5.49 x 2.60 x 5.50 mm
