mehmetfurkandogan/Microprocessor-Controlled-Prosthetic-Knee/(list of files, cad)

Other CAD files:
Simulink_Simulation/karbon ayak/karbon ayak step/PR01.KL.27R.SLDASM
Simulink_Simulation/denem.SLDPRT
Simulink_Simulation/karbon ayak/KA.KL.027U.SLDPRT
Simulink_Simulation/karbon ayak/karbon ayak step/TI.K7.0003.STEP
Simulink_Simulation/karbon ayak/karbon ayak step/YH.PU.K207.STEP
Simulink_Simulation/karbon ayak/karbon ayak step/HP.VI.I612.STEP
Simulink_Simulation/C-Leg STEP/Valf/dis_parca_step.STEP
Simulink_Simulation/karbon ayak/DT.2P. KTB2.SLDPRT
Simulink_Simulation/karbon ayak/KA.KL.027A.SLDPRT
Simulink_Simulation/karbon ayak/karbon ayak step/TI.VI.A816.STEP
Simulink_Simulation/karbon ayak/karbon ayak step/TI.VI.A820.STEP
Simulink_Simulation/C-Leg STEP/Valf/montaj_ic_aksam_v2.SLDASM
Simulink_Simulation/C-Leg STEP/Valf/o_ring_step.SLDPRT
Simulink_Simulation/karbon ayak/DT.2P. KTB2.SLDDRW
Simulink_Simulation/karbon ayak/DT.2P.KTBN.SLDDRW
Simulink_Simulation/karbon ayak/HP.VI.I612.SLDDRW
Simulink_Simulation/karbon ayak/KA.KL.027A.SLDDRW
Simulink_Simulation/karbon ayak/KA.KL.027U.SLDDRW
Simulink_Simulation/karbon ayak/PR01.KL.27R.SLDDRW
Simulink_Simulation/karbon ayak/TI.2K.PT10.SLDDRW
Simulink_Simulation/karbon ayak/TI.K2.0004.SLDDRW
Simulink_Simulation/karbon ayak/TI.K2.0014.SLDDRW
Simulink_Simulation/karbon ayak/TI.K3.0025.SLDDRW
Simulink_Simulation/karbon ayak/TI.K7.0003.SLDDRW
Simulink_Simulation/karbon ayak/TI.VI.A816.SLDDRW
Simulink_Simulation/karbon ayak/TI.VI.A820.SLDDRW
Simulink_Simulation/karbon ayak/YH.PU.K207.SLDDRW
Simulink_Simulation/simulink/strain_gage_parcasi_kare.SLDPRT
