mehmetfurkandogan/Microprocessor-Controlled-Prosthetic-Knee/Simulink_Simulation/C-Leg STEP/aciklik_tablosu.xls

degree | mm^2
-33 | 2.9
-30 | 2.78
-27 | 2.58
-24 | 2.3
-21 | 1.94
-18 | 1.5
-15 | 1.02
-12 | 0.56
-9 | 0.18
-6 | 0
-3 | 0
0 | 0
3 | 0
6 | 0
9 | 0
12 | 0
15 | 0
18 | 0
21 | 0
24 | 0
27 | 0
30 | 0
33 | 0
