mehmetfurkandogan/Microprocessor-Controlled-Prosthetic-Knee/Simulink_Simulation/karbon ayak/PR01.KL.27R.pdf

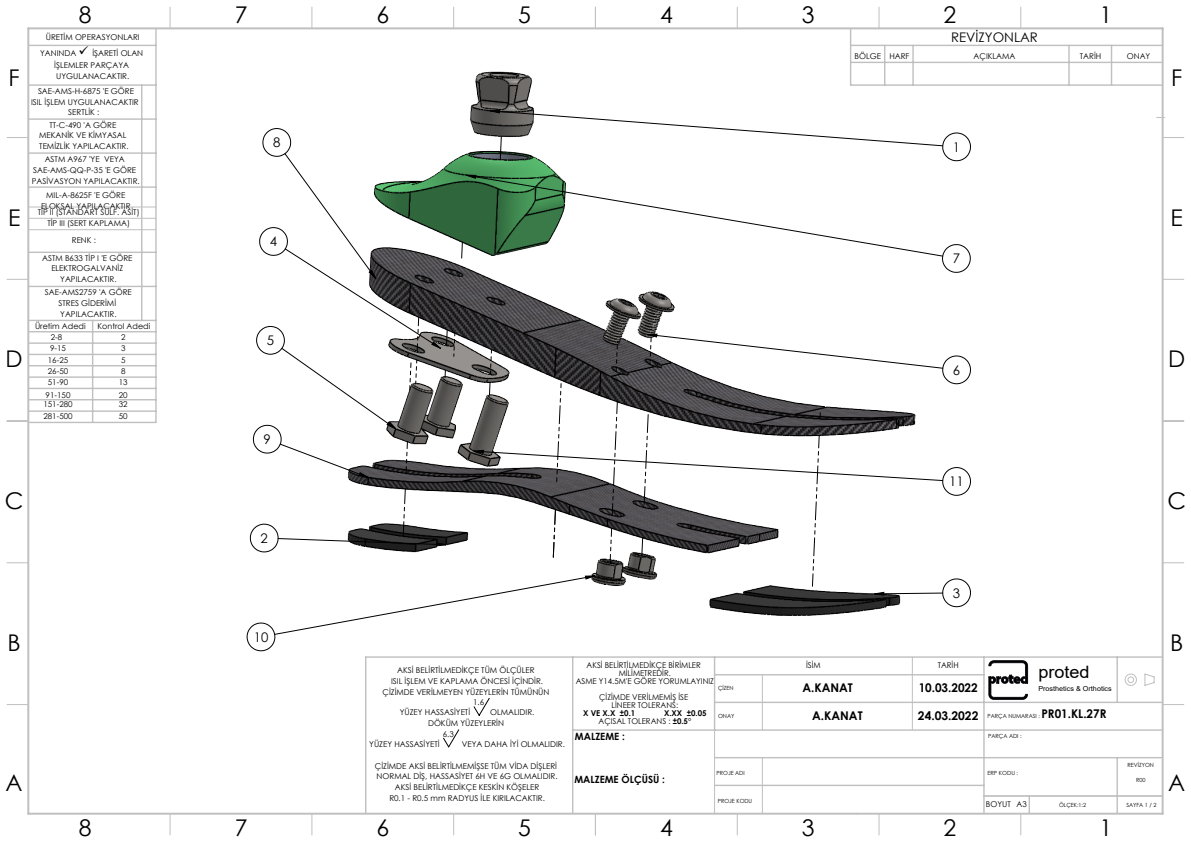
[picture p53: page 1]
MALZEME ÖLÇÜSÜ :; BOYUT A3; ÖLÇEK:1:2; SAYFA 1 / 2; PROJE KODU; PROJE ADI; ERP KODU :

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

SAE-AMS-H-6875 'E GÖRE ISIL İŞLEM UYGULANACAKTIR SERTLİK :

TT-C-490 'A GÖRE MEKANİK VE KİMYASAL TEMİZLİK YAPILACAKTIR.

ASTM A967 'YE VEYA SAE-AMS-QQ-P-35 'E GÖRE PASİVASYON YAPILACAKTIR.

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

SAE-AMS2759 'A GÖRE STRES GİDERİMİ YAPILACAKTIR.

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

AKSİ BELİRTİLMEDİKÇE TÜM ÖLÇÜLER ISIL İŞLEM VE KAPLAMA ÖNCESİ İÇİNDİR. ÇİZİMDE VERİLMEYEN YÜZEYLERİN TÜMÜNÜN 1.6 YÜZEY HASSASİYETİ OLMALIDIR. DÖKÜM YÜZEYLERİN 6.3 YÜZEY HASSASİYETİ VEYA DAHA İYİ OLMALIDIR. ÇİZİMDE AKSİ BELİRTİLMEMİŞSE TÜM VİDA DİŞLERİ NORMAL DİŞ, HASSASİYET 6H VE 6G OLMALIDIR. AKSİ BELİRTİLMEDİKÇE KESKİN KÖŞELER R0.1 - R0.5 mm RADYUS İLE KIRILACAKTIR. | AKSİ BELİRTİLMEDİKÇE BİRİMLER MİLİMETREDİR. ASME Y14.5M'E GÖRE YORUMLAYINIZ ÇİZİMDE VERİLMEMİŞ İSE LİNEER TOLERANS: X VE X.X ±0.1 X.XX ±0.05 AÇISAL TOLERANS : ±0.5° | İSİM | TARİH | proted Prosthetics & Orthotics

ÇİZEN | A.KANAT | 10.03.2022

ONAY | A.KANAT | 24.03.2022 | PARÇA NUMARASI : PR01.KL.27R

MALZEME : | PARÇA ADI :

NUMARA | PARÇA NUMARASI | MİKTAR | PARÇA ADI | MALZEME | MALZEME ÖLÇÜSÜ
1 | TI.2K.PT10 | 1 | PİRAMİT | 1.4021 (X20Cr13) | Ø25 X 26
2 | DT.2P. KTB2 | 1 | KAUCUK TABANLIK | KAUCUK
3 | DT.2P.KTBN | 1 | KAUCUK TABANLIK | KAUCUK
4 | YH.PU.K207 | 1 | PUL | SAC LEVHA | 1.5 mm sac
5 6 | TI.VI.A816 HP.VI.I612 | 2 2 | ALTI KÖŞE BAŞLI CİVATA BOMBE BAŞLI FLANŞLI CİVATA | 1.4021 (X20Cr13) AISI 304 | M8 x 16 10.9-12.6 KALİTE M6 X 12 Kalite 10.9
7 | TI.K2.0004 | 1 | LARA ADAPTÖR 26-29 | 7075-T6, Levha (SS)
8 | KA.KL.027U | 1 | LARA KOMPOZİT ÜST PLAKA | KOMPOZİT | 27R
9 | KA.KL.027A | 1 | LARA KOMPOZİT ALT PLAKA | KOMPOZİT | 27R
10 | TI.K7.0003 | 2 | LARA ÖZEL SOMUN | 1.4541 (X6CrNiTi18-10) | Ø12
A | 11 | TI.VI.A820 | 1 | ALTI KÖŞE BAŞLI CİVATA | 1.4021 (X20Cr13) | M8 x 20 10.9-12.6 KALİTE | A
B | | | | | | | B
C | C
D | D
E | E
F | F

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
