mehmetfurkandogan/Microprocessor-Controlled-Prosthetic-Knee/(commit log)

2023-01-13 Piston movement added
2023-01-14 Inertia Measurement added
    [log.csv]
2023-01-17 Minor changes to piston movement
2023-01-19 added friction to equation of motion
    also changed the start of the sampled data
2023-01-22 Prosthetic simulation is updated
    Ground reaction forces are added
2023-01-23 Simulink simulation was added
    [01-ADAPTÖR.STEP, Assem1.SLDASM, Cool-Step Govde_v2.step.SLDPRT, DT.2P. KTB2.SLDDRW, DT.2P. KTB2.SLDPRT, DT.2P. KTB2.STEP, DT.2P.KTBN.SLDDRW, DT.2P.KTBN.SLDPRT]
2023-01-26 Fuzzy Logic documents added
    [knee_moment.xlsx, knee_omega.xlsx]
2023-01-27 Raspberry Pi Pico Codes are added
2023-01-30 New and modified documents
    Fuzzy - modified
    damping coefficient data - added
    [damping_coefficient.xls, damping_coefficient_data.xls]
